heinerbehrends/hearbeat-to-midi/hardware/sensor_case/sensor_case.stl

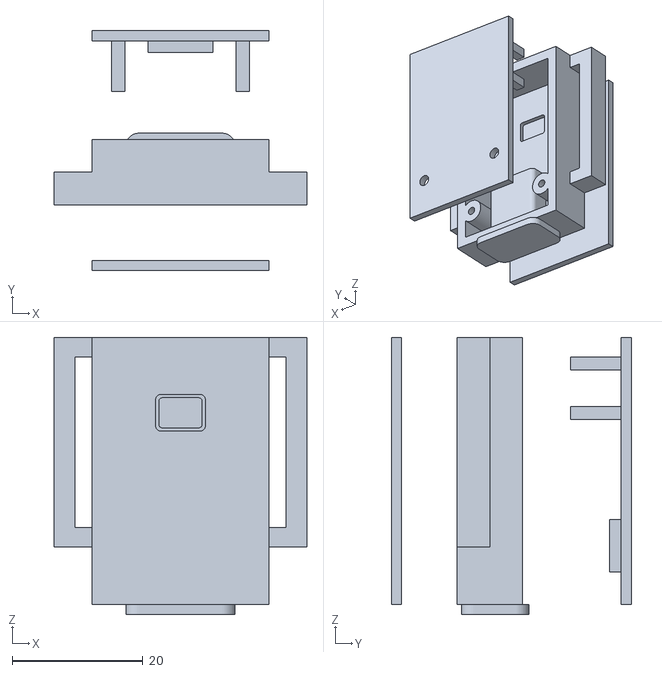
[picture p1: CAD file, 2026-10-26]
hardware/sensor_case/sensor_case.stl
38.6 x 36.6 x 42.3
