heinerbehrends/hearbeat-to-midi/(commit log)

2026-09-05 First commit, monitor shows sensor data
2026-09-05 Smoke test with reset button click
2026-09-05 Add large partition file, assertion
    [large_partitions.csv]
2026-09-08 Working smoke test with pressing button
2026-09-08 Install the usb midi and sensor deps
2026-10-21 Fix the script that talks to sensor
    [sensor_probe.cpp]
2026-10-21 Add HeartTempo filter, sensor probe and on-device tests
    - lib/HeartTempo: validate -> median outlier gate (with sustained-change
    consensus) -> time-constant EMA -> slew limit; tempo holds through gaps,
    finger-off and sensor loss
    - diag env: probe that finds the SEN0344 on any GPIO pair (I2C or UART)
    and prints readings in serial-plotter format
    - test_heart_tempo: 12 Unity tests incl. a recorded sensor session
    - move smoke test into test/test_smoke/ (one folder per suite)
2026-10-21 Send MIDI clock that follows the heart rate
    Sensor task on core 0 polls the SEN0344 (I2C, SDA 17 / SCL 9) every 4 s and
    feeds HeartTempo. Clock task on core 1 sends 24 PPQN MIDI clock at the
    current tempo, starting at 90 BPM and never stopping. The onboard RGB LED
    shows the state: red blinking = no sensor, red = no finger, amber =
    acquiring, green flash per beat = locked. Readings are logged in
    serial-plotter format.
2026-10-22 Add feedback and rate switches, settings file, UART dev port
    - include/Settings.h: every tunable value in one place (pins, feedback
    offset and steering limits, slow/medium/fast rate presets, filter, LED)
    - HeartTempo: setFeedback (-/0/+, clamped to 55-130 without pushing
    against the switch) and setRate (live, no tempo jump); glide limit is now
    0.15 % of tempo per beat, below the tempo-drift perception threshold
    - Switch3: debounced ON-OFF-ON switch helper
    - LED: amber whenever the last reading was missing or rejected; external
    LED on GPIO21; readable state/feedback/rate lines in the log
    - Serial, upload and tests move to the UART (CH343) port with auto-reset,
    so the native USB port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
    [Settings.h, main.cpp, sensor_probe.cpp]
2026-10-23 Harden sensor reads, clock output and filter after code review
    - Read the SEN0344 directly and check every I2C transfer; a failed read
    counts as a missing poll instead of decoding an uninitialised buffer
    - Re-send "start collecting" after repeated empty readings, restart the
    I2C driver after repeated failed polls
    - HeartTempo: a few missing polls keep the lock; NoSensor -> NoFinger as
    soon as the sensor answers again; accept steady climbs/falls the gate
    can't follow; first lock starts the estimate at the measured value;
    history seeded only with the readings that agreed
    - Clock: skip missed ticks after a stall instead of bursting, don't queue
    ticks while USB is unmounted or suspen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
    [Settings.h, main.cpp]
2026-10-23 Add transport switch, stepped tempo mode and REAPER tempo support
    - Transport switch (third 8016, GPIO15/16): stop / run / run stepped.
    Starting sends Song Position 0 + Start right after a clock tick, stop
    sends Stop; the clock keeps running. Until the switch is wired
    (TRANSPORT_SWITCH_INSTALLED = false) the BOOT button cycles the modes.
    - Stepped mode: the clock tempo holds for STEP_BEATS (16) beats counted
    from Start, then jumps to the current glide tempo.
    - Tempo also sent as a 14-bit CC pair (bpm x 64, CC 20/52, channel 16) for
    REAPER, which doesn't follow MIDI clock tempo; the REAPER script in
    tools/reaper/ applies it to the first tempo marker.
    - Log: Clock (tempo actually s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
    [Settings.h, main.cpp]
2026-10-24 Add parametric forehead case for the heart rate sensor
    OpenSCAD model with every dimension as a parameter: sensor pocket with the
    glass standing 0.5 mm proud into 1 mm black felt (light seal), panel
    USB-C socket (4P data) on top, strap loops for 26 mm elastic, screwed lid,
    and a 2D felt cutting template. README covers printing (opaque black
    filament, opacity test) and assembly.
    Not rendered or test-printed yet.
    [sensor_case.scad]
2026-10-24 Make the MIDI firmware the default PlatformIO environment
    Without default_envs, Upload in VS Code builds and uploads every env in
    turn, so the diag probe (no USB MIDI) ended up on the board and DAWs no
    longer saw the device.
2026-10-25 Reject sensor junk: SpO2-valid flag, caution above 100 bpm, start at 70
    - Treat the heart rate as missing while the sensor's SpO2-valid flag
    (result byte 1) is 0: recorded sessions show a drifting, too-high series
    exactly then (REQUIRE_SPO2_VALID)
    - Readings above 100 bpm only count when they continue smoothly from the
    last kept reading (within 8 bpm) or three in a row agree; discarded
    readings don't count toward "no finger"
    - Optional raw 8-byte sensor logging (LOG_RAW_SENSOR_BYTES)
    - Clock starts at 70 bpm
    - 27 on-device tests, all passing
    [Settings.h, main.cpp]
2026-10-25 Turn off raw sensor byte logging, ignore monitor log files
2026-10-26 Add tray scad and sensor_case stl
    [sensor_case.stl, tray.scad]
2026-10-26 Close junk paths found in review: caution, gate cap, gaps, lock timeout
    - Caution rule: a high reading only passes when it is itself one of the
    agreeing readings, not because older ones agree
    - Outlier gate capped at GATE_MAX_BPM (12), so a widely spread history
    after a ramp can't open it; an accepted ramp moves the estimate toward
    its median instead of its end
    - A missing reading breaks a run of high readings; caution memory is
    forgotten on NoFinger/NoSensor
    - A lock with no accepted reading for LOCK_TIMEOUT_POLLS (8) drops back to
    acquiring (tempo holds), so junk can't keep a dead lock alive
    - Firmware only re-sends "start collecting" when the sensor reports no
    heart rate at al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
    [Settings.h, main.cpp]
2026-10-26 Fix sensor case and tray issues found in review
    Sensor case:
    - README: print skin face down (open side up was a 22 x 38 mm bridge)
    - Strap loops sit fully alongside the body and merge into the wall, so
    both end webs are attached
    - Lid posts press the sensor board onto the skin plate (glass can't lift
    out of the window); replaces the too-thin foam
    - Socket cradle and lid rib stop 3 mm short of the wall for the rubber
    barbs; cradle 0.1 mm lower
    - Screw bosses merged 0.8 mm into the side walls instead of touching
    - sock_depth measured from the outside of the wall: case 2 mm shorter
    - Warn against plugging the sensor socket into a USB-A charger (5 V)
    Tray: plate length set by the lid's co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
    [sensor_case.scad, tray.scad]
2026-10-26 Make clock and transport output robust against a full USB buffer
    - Clock ticks get ~1 ms of retries when the TX buffer is full; ticks that
    still can't be sent don't advance the phrase counter, so device and DAW
    count the same ticks. After a beat or more of lost ticks, restart the
    DAW from the top (Stop, SPP 0, Start) to bring it back in phase.
    - Start/Stop that couldn't be sent stay pending and are retried after the
    next tick; every Start is preceded by Stop so SPP is always honoured;
    a Stop is re-sent when the host reconnects while stopped.
    - A run -> stop -> run flick faster than one tick still restarts.
    - Leaving stepped mode waits for the next phrase boundary, where the held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
2026-10-26 Rework REAPER script, bring tickets and README up to date
    REAPER script (review findings):
    - read idx 0 once and walk back from it, so no event is handled twice
    - compare with the marker's actual tempo, so manual edits, undo or a
    project switch are corrected by the next resend; MIN_CHANGE 0.05 bpm
    - console messages instead of failing silently: first tempo received,
    nothing received after 5 s, more than one tempo marker
    - status byte checked before the input-name lookup; marker set by time
    position only; clean toolbar toggle via set_action_options
    - header: transport switch / BOOT instead of the old pedal
    Docs: tickets get an "implemented" status (code + unit tests done,
    hardware chec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
2026-10-26 Add Seeed XIAO ESP32-S3 Plus as the build board
    - env:xiao-s3-plus: board seeed_xiao_esp32_s3_plus (16 MB / 8 MB PSRAM),
    TinyUSB with MIDI + USB CDC serial on its single USB-C port, product name
    set at build time, uploads via 1200 baud touch (no buttons)
    - Settings.h: all pins in one block per board; XIAO uses only the front
    pins (I2C on the labelled D4/D5, switches D0/D1, D8/D9, D10/D7, LED D3),
    leaving D2 (strapping) and D6 (boot TX) free
    - Serial TX timeout 0 when Serial is USB CDC, so the log never stalls
    - xiao_holder.scad: shelf glued inside a 1590A end wall so the XIAO's own
    USB-C port is used through the wall (no laptop panel socket); echoes
    the wall opening height
    - Encl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
    [xiao_holder.scad]
2026-10-26 XIAO holder: measured PCB thickness and USB-C overhang
    [xiao_holder.scad]
2026-10-26 Enclosure README: XIAO holder is ~25 mm deep with the measured USB-C overhang
2026-10-26 README: document the two boards, environments and shared settings
2026-10-26 Add transport LED: stopped, beat, tempo direction, stepped count-in
    Second WS2812D-F8 on its own data pin (XIAO D2 / DevKit GPIO10); the first
    LED now shows only the sensor state.
    - stopped: dim white
    - playing: a flash on every beat counted from Start (in phase with the
    DAW), brighter on downbeats; white = tempo holding, orange = rising,
    blue = falling (glide direction while locked)
    - stepped: count-in over the last 4 beats before a step in the step's
    colour, growing brighter; one long flash on the step itself
    The clock task publishes ticks since Start and the coming/last step
    direction; colours, levels, timing and thresholds are in Settings.h.
    Ticket 009, README and enclosure wiring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
2026-10-26 HeartTempo: setConfig for live configuration changes
    Replaces all tunables while keeping tempo, estimate, state and collected
    readings, so runtime settings can change the filter without a jump.
    Buf::push now also trims a buffer that holds more than its (shrunk)
    capacity. Two new unit tests.
2026-10-26 Runtime settings over serial, saved in NVS, plus double time
    - lib/Params: registry of 25 runtime parameters (defaults from Settings.h,
    ranges, rules from the static_asserts), line-based command console
    (help/get/set/save/reset), clock-grid helpers. Pure C++.
    - lib/ParamNvs: ParamStore on Preferences (namespace hr2midi, schema version).
    - main.cpp: sensor task reads serial commands and applies changes
    (HeartTempo::setConfig); the clock task and loop() read live values from
    atomics. step_beats changes on a phrase boundary common to old and new
    length; tempo_multiplier (1/2, double time) scales the clock interval on
    the next bar line, capped at MAX_CLOCK_BPM = 240.
    - Settings.h: [r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
    [Settings.h, main.cpp]
2026-10-26 Control from the DAW: incoming MIDI CC on channel 16
    - lib/Params/MidiControl: pure mapping of CC 21-24 (step_beats 4/8/16/32,
    rate preset slow/medium/fast, feedback_offset_bpm 0-10 in 0.1 steps,
    tempo_multiplier 1/2), channel/CC filtering (our own tempo CC 20/52,
    other channels and non-CC messages ignored), latest value per control,
    act only when the mapped value changes. Changes go through Params::set
    like `set`, are not saved, and are logged with their source
    (param: step_beats 16 -> 32 (cc21=100)). A step length at or below
    count_in_beats lowers count_in_beats first.
    - RateSelect: CC 22 overrides the rate switch until the switch moves.
    - main.cpp: packets are drained in Tin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
2026-10-26 Tickets 012-017: manual test checklists (DAW sync, modes, CC control, LEDs, REAPER, web page)
    Index rows follow once the CC-control work (011) has updated tickets/README.md.
2026-10-26 Settings web page over Web Serial, with demo mode
    docs/index.html: static page (no build, no external resources) that builds
    its form from `get`, sends set/reset/save through a one-at-a-time command
    queue, tracks unsaved changes, follows param: lines from other sources and
    shows the live > log with a 2-minute chart. ?demo runs a simulated device
    with the same protocol through the same code paths.
2026-10-26 update sensor case drawing
    [sensor_case.stl]
2026-10-26 Tickets: bring up to date, add 018-021
    - New: 018 decide on dropping the rate toggle (backlog), 019 wire the
    transport switch, 020 build the 1590A box and verify the XIAO, 021 print
    the sensor case
    - 004 rewritten as heart-rate tempo limits; clock cap and intervalFor() guard
    are the separate, already implemented last stage
    - 001/002/003/006/009/010: tick criteria covered by tests or log lines, drop
    stale out-of-scope notes, note per-board pins, point hardware checks to the
    manual test tickets 012-017
    - 010 parameter table marked as at implementation; 011 CC table replaced by a
    link; 016/017 updated for the REAPER README and the page's reconnect
    - Index: new rows, status definitio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
2026-10-26 Comments: fix outdated notes, add filter and sensor rationale
    - Settings.h: XIAO D2 is the transport LED (only D6 is free); measured
    scatter behind the filter numbers; drift/step perception sources;
    SpO2-valid flag is useful but not watertight
    - ParamConsole.h / Params.h: the Web Serial page exists (docs/)
    - main.cpp: loop() drives both LEDs; LED colour comments point to README /
    Settings.h instead of repeating them
    - platformio.ini: XIAO DTR comment consistent with docs/README
    Comments only; both environments build.
    [Settings.h, main.cpp]
2026-10-26 Docs: troubleshooting, log fields, test suites, settings page, REAPER README
    - README: settings page link, XIAO workflow (only here), test suites incl.
    test_smoke, plotter log field table, Troubleshooting section, rate toggle
    under consideration (018), REAPER details moved to tools/reaper/README.md
    - tools/reaper/README.md: why, setup, run/stop, messages, findings, limits;
    the script header points to it
    - hardware/enclosure/README.md: XIAO development section replaced by a
    pointer; note on ticket 018
    - hardware/sensor_case/README.md: placement and stray light
    - docs/README.md: live Pages URL; DTR wording
2026-10-26 Review fixes: XIAO settings page transport, page state, boot load reason
    Page (docs/index.html): set DTR for a native USB port (XIAO) and clear it
    for a UART bridge (DevKit), decided by vendor id; the "no data" check no
    longer counts the page's own echo; Reload keeps the saved-value baseline;
    disconnect clears the form and values; the unsaved flag follows the values.
    Firmware: a short CDC transmit timeout instead of 0 so `get` isn't cut;
    boot logs the rule that made it ignore the saved values (page shows it).
    Docs: reset <name> is checked like set; a re-sent CC 22 value is ignored
    after the switch moved. Tests for parse edge cases, load error, save
    failure and a refused reset.
    Co-Authored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
    [main.cpp]
2026-10-27 rate_preset: the rate preset in use as a runtime setting
    New setting rate_preset (-1 slow, 0 medium, 1 fast), saved like the others.
    The rate switch (when it moves), CC 22 and set all write it; the last change
    wins. At power-on a saved value applies, otherwise the switch position
    (Params::loadedFromStore). RateSelect's override logic is replaced by
    RateSwitchSource; CC 22 goes through Params::set like CC 23/24.
    Settings page: a Slow/Medium/Fast select in the main group; the demo device
    mirrors the setting, its rate line, the glide and a CC 22 turn.
    Docs: README, tickets 010, 011, 014, 018. Tests updated and added.
    [Settings.h, main.cpp]
